Alessandros-tech/2.4GHz-Antenna-Design/docs/Report_Attività_Sperimentale_Dipolo_2.4GHz.pdf

## Reportdell’attività sperimentale: realizzazionedell’antenna adipolo

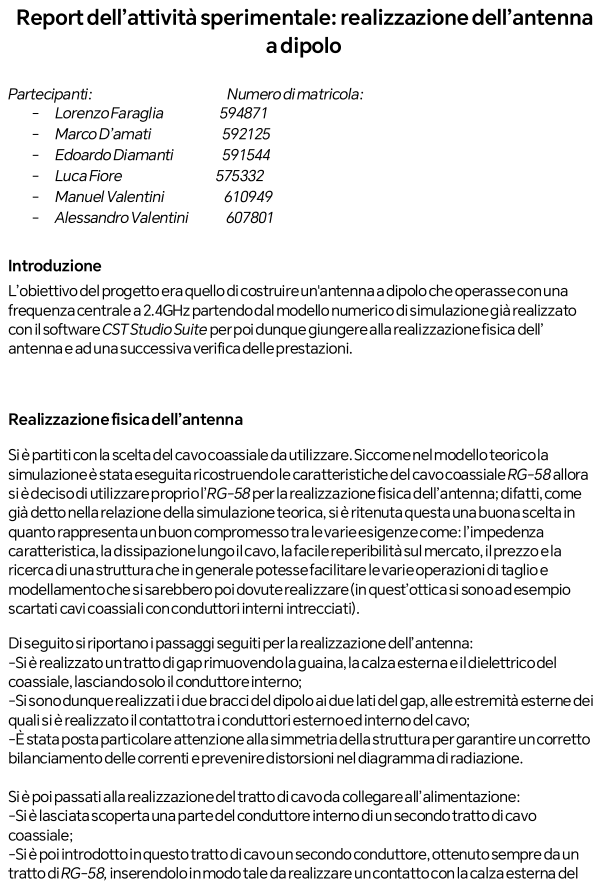
[picture p7: page 1]
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

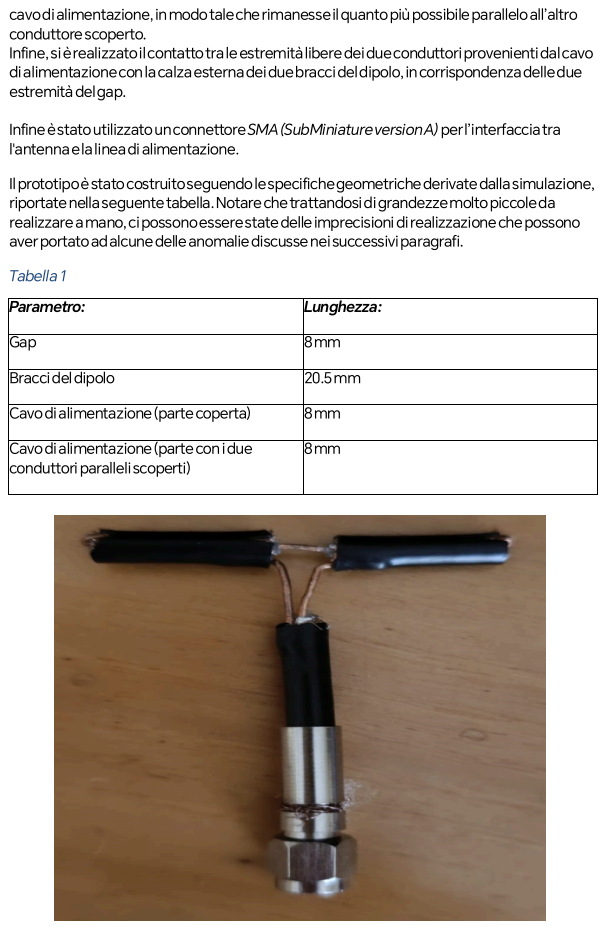
[picture p8: page 2]
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

cavodialimentazione,inmodotalecherimanesseilquantopiùpossibileparalleloall’altro
conduttorescoperto.
Infine,sièrealizzatoilcontattotraleestremitàliberedeidueconduttoriprovenientidalcavo
dialimentazioneconlacalzaesternadeiduebraccideldipolo,incorrispondenzadelledue
estremitàdelgap.

Gap | 8mm

Braccideldipolo | 20.5mm

Cavodialimentazione(partecoperta) | 8mm

Cavodialimentazione(parteconidue conduttoriparalleliscoperti) | 8mm

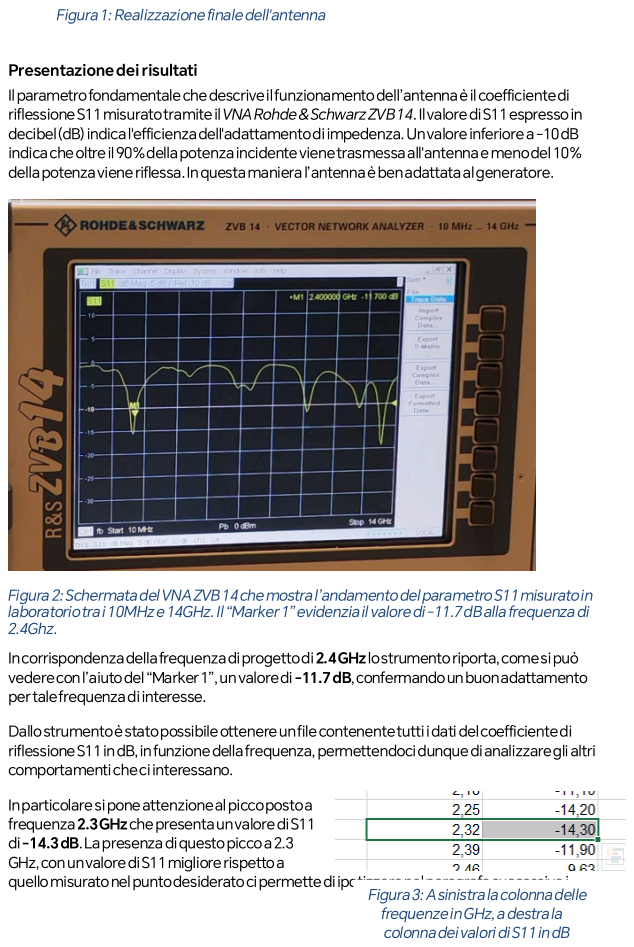
[picture p9: page 3]
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

Presentazionedei risultati
Ilparametrofondamentalechedescriveilfunzionamentodell’antennaèilcoefficientedi
decibel(dB)indical'efficienzadell'adattamentodiimpedenza.Unvaloreinferiorea-10dB
indicacheoltreil90%dellapotenzaincidentevienetrasmessaall'antennaemenodel10%
dellapotenzavieneriflessa.Inquestamanieral’antennaèbenadattataalgeneratore.

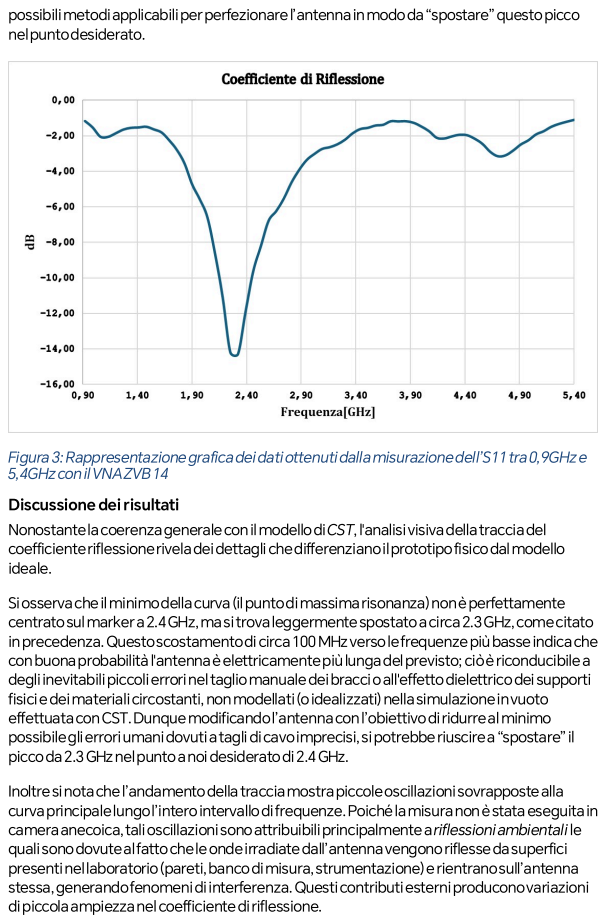
[picture p10: page 4]
Nonostantelacoerenzageneraleconilmodellodi; , l'analisivisivadellatracciadel; cameraanecoica,talioscillazionisonoattribuibiliprincipalmentea

possibilimetodiapplicabiliperperfezionarel’antennainmododa“spostare”questopicco
nelpuntodesiderato.

Discussione dei risultati
coefficienteriflessioneriveladeidettaglichedifferenzianoilprototipofisicodalmodello
ideale.

Siosservacheilminimodellacurva(ilpuntodimassimarisonanza)nonèperfettamente
centratosulmarkera2.4GHz,masitrovaleggermentespostatoacirca2.3GHz,comecitato
inprecedenza.Questoscostamentodicirca100MHzversolefrequenzepiùbasseindicache
conbuonaprobabilitàl'antennaèelettricamentepiùlungadelprevisto;ciòèriconducibilea
degliinevitabilipiccolierrorineltagliomanualedeibraccioall'effettodielettricodei supporti
fisiciedeimaterialicircostanti,nonmodellati(oidealizzati)nellasimulazioneinvuoto
effettuataconCST.Dunquemodificandol’antennaconl’obiettivodiridurrealminimo
possibileglierroriumanidovutiataglidicavoimprecisi,sipotrebberiuscirea“spostare”il
piccoda2.3GHznelpuntoanoidesideratodi2.4GHz.

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

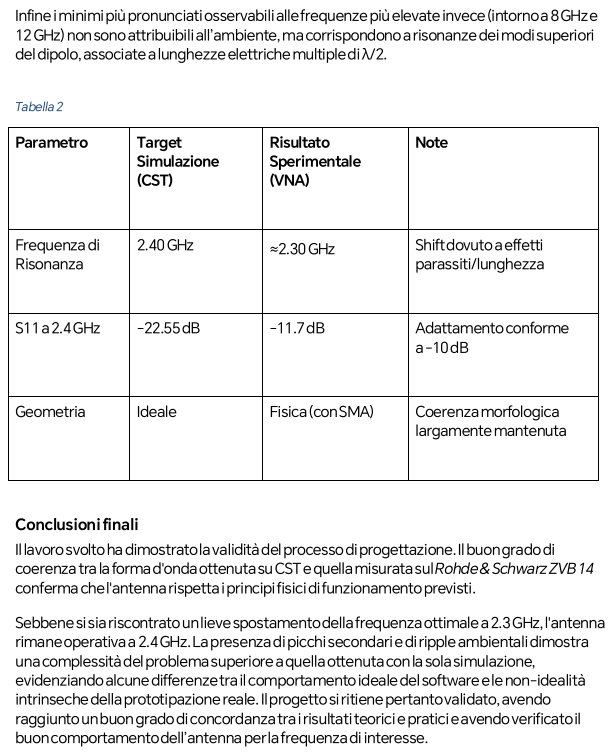
[picture p11: page 5]
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

Parametro | Target Simulazione (CST) | Risultato Sperimentale (VNA) | Note

Frequenzadi Risonanza | 2.40GHz | ≈2.30GHz | Shiftdovutoaeffetti parassiti/lunghezza

S11a2.4GHz | -22.55dB | -11.7dB | Adattamentoconforme a-10dB

Geometria | Ideale | Fisica(conSMA) | Coerenzamorfologica largamentemantenuta

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
